LukiBa/RS485-IO-Extension/IO_Overview.xlsx

Raum | HWR | WC unten | Vorhaus | Küche | Speis | Wohnzimmer | Büro | Stiege | Gang oben | KZ Ost | KZ Mitte | KZ Wesst | Schlafzimmer | Schrankraum | Bad | WC Oben | Aussen | Summe | A1 | Q1 | Licht Zugang 1, Licht Zugang 2
Licht 24V | 0 | 1 | 2 | 7 | 0 | 3 | 0 | 1 | 2 | 1 | 1 | 1 | 5 | 2 | 4 | 1 |  | 31 |  | Q2 | Licht Terasse 1, Licht Terasse 2
Licht 230V | 2 | 0 | 0 | 0 | 1 | 0 | 1 | 0 | 0 | 0 | 0 | 0 | 0 | 0 | 0 | 0 |  | 4 |  | Q3 | Licht Terasse 3, Licht Terasse 4
Jalousine | 1 | 0 | 0 | 4 | 0 | 2 | 1 | 0 | 0 | 2 | 1 | 1 | 2 | 1 | 1 | 0 |  | 16 |  | Q4 | Sensorlicht 1,2,3
 |  |  |  |  |  |  |  |  |  |  |  |  |  |  |  |  |  |  |  | Q5 | Licht Küchenzeile
 |  |  |  |  |  |  |  |  |  |  |  |  |  |  |  |  |  |  |  | Q6 | Licht Speis
Relais | 36 |  |  |  |  |  |  |  |  |  |  |  |  |  |  |  |  |  |  | Q7 | Licht HWR1
24V PWMs | 31 |  |  |  |  |  |  |  |  |  |  |  |  |  |  |  |  |  |  | Q8 | Licht HWR2
 |  |  |  |  |  |  |  |  |  |  |  |  |  |  |  |  |  |  | A2 | D1 | Licht 24VDC Spots Essküche Mitte (Spot Kamin) | 1.25 | 0.16
Summe IOs | 67 |  |  |  |  |  |  |  |  |  |  |  |  |  |  |  |  |  |  | D2 | Licht 24VDC Schattenfuge 1 | 1.5 | 0.1333333333
 | 6 |  |  |  |  |  |  |  |  |  |  |  |  |  |  |  |  |  |  | D3 | Licht 24VDC Schattenfuge 3 | 1.5 | 0.1333333333
 |  |  |  |  |  |  |  |  |  |  |  |  |  |  |  |  |  |  |  | D4 | Licht 24VDC Schattenfuge 4 | 1.5 | 0.1333333333
 |  |  |  |  |  |  |  |  |  |  |  |  |  |  |  |  |  |  |  | D5 | Licht 24VDC Spots Küche | 1.25 | 0.16
 |  |  |  |  |  |  |  |  |  |  |  |  |  |  |  |  |  |  |  | D6 | Licht 24VDC Esszimmer | 0.6 | 0.3333333333
 |  | 36 | 27 | 63 |  |  |  |  |  |  |  |  |  |  |  |  |  |  |  | D7 | Licht 24VDC Kochinsel | 0.6 | 0.3333333333
 |  |  |  | 5 |  |  |  |  |  |  |  |  | 64 |  |  |  |  |  |  | D8 | Licht 24VDC WC OG | 0.2 | 1
 |  |  |  |  |  |  |  |  |  |  |  |  |  |  |  |  |  |  |  | Q1 | Jalousie KZ Ost1
 |  |  |  |  |  |  |  |  |  |  |  |  |  |  |  |  |  |  |  | Q2
 |  |  |  |  |  |  |  |  |  |  |  |  |  |  |  |  |  |  |  | Q3 | Jalousie KZ Ost2
 |  |  |  |  |  |  |  |  |  |  |  |  |  |  |  |  |  |  |  | Q4
 |  |  |  |  |  |  |  |  |  |  |  |  |  |  |  |  |  |  |  | Q5 | Jalousie KZ West
 |  |  |  |  |  |  |  |  |  |  |  |  |  |  |  |  |  |  |  | Q6
 |  |  |  |  |  |  |  |  |  |  |  |  |  |  |  |  |  |  |  | Q7 | Jalousie KZ Mitte
 |  |  |  |  |  |  |  |  |  |  |  |  |  |  |  |  |  |  |  | Q8
Arduino CN7 | 17 |  |  |  |  |  |  |  |  |  |  |  |  |  |  |  |  |  |  | Q9 | Licht 230V WC UG
Arduino CN8 | 2
Arduino CN9 | 21 |  |  |  |  |  |  |  |  |  |  |  |  |  |  |  |  |  | A3 | D1 | Licht 24VDC Spots Dusche | 0.9 | 0.2222222222
CN10 | 26 |  |  |  |  |  |  |  |  |  |  |  |  |  |  |  |  |  |  | D2 | Licht 24VDC Spots Badspiegel | 0.625 | 0.32
 |  |  |  |  |  |  |  |  |  |  |  |  |  |  |  |  |  |  |  | D3 | Licht 24VDC Badewanne | 0.625 | 0.32
 |  |  |  |  |  |  |  |  |  |  |  |  |  |  |  |  |  |  |  | D4 | Licht 24VDC Bad | 0.6 | 0.3333333333
 |  |  |  |  |  |  |  |  |  |  |  |  |  |  |  |  |  |  |  | D5 | Licht 24VDC WZ | 0.6 | 0.3333333333
 | 66 |  |  |  |  |  |  |  |  |  |  |  |  |  |  |  |  |  |  | D6 | LED WZ 1 | 1 | 0.2
 |  |  |  |  |  |  |  |  |  |  |  |  |  |  |  |  |  |  |  | D7 | LED WZ 2 | 1 | 0.2
 |  |  |  |  |  |  |  |  |  |  |  |  |  |  |  |  |  |  |  | D8 | Licht 24VDC KZ West | 0.6 | 0.3333333333
 |  |  |  |  |  |  |  |  |  |  |  |  |  |  |  |  |  |  |  | Q1 | Jalousie SZ 1
 |  |  |  |  |  |  |  |  |  |  |  |  |  |  |  |  |  |  |  | Q2
 |  |  |  |  |  |  |  |  |  |  |  |  |  |  |  |  |  |  |  | Q3 | Jalousie SZ 2
 |  |  |  |  |  |  |  |  |  |  |  |  |  |  |  |  |  |  |  | Q4
 |  |  |  |  |  |  |  |  |  |  |  |  |  |  |  |  |  |  |  | Q5 | Jalousie Bad
 |  |  |  |  |  |  |  |  |  |  |  |  |  |  |  |  |  |  |  | Q6
 |  |  |  |  |  |  |  |  |  |  |  |  |  |  |  |  |  |  |  | Q7 | Jalousie Schrankraum
 |  |  |  |  |  |  |  |  |  |  |  |  |  |  |  |  |  |  |  | Q8
 |  |  |  |  |  |  |  |  |  |  |  |  |  |  |  |  |  |  |  | Q9 | Licht Spiegel Vorhaus
 |  |  |  |  |  |  |  |  |  |  |  |  |  |  |  |  |  |  | A4 | D1 | Licht 24VDC SZ2 | 0.6 | 0.3333333333
 |  |  |  |  |  |  |  |  |  |  |  |  |  |  |  |  |  |  |  | D2 | Licht 24VDC KZ Ost | 0.6 | 0.3333333333
 |  |  |  |  |  |  |  |  |  |  |  |  |  |  |  |  |  |  |  | D3 | Licht 24V SZ Nachttisch 2 | 0.2 | 1
 |  |  |  |  |  |  |  |  |  |  |  |  |  |  |  |  |  |  |  | D4 | Licht 24V SZ | 0.2 | 1
 |  |  |  |  |  |  |  |  |  |  |  |  |  |  |  |  |  |  |  | D5 | Licht 24V SZ Nachttisch 1 | 0.2 | 1
 |  |  |  |  |  |  |  |  |  |  |  |  |  |  |  |  |  |  |  | D6 | Licht 24VDC Schrankraum | 1 | 0.2
 |  |  |  |  |  |  |  |  |  |  |  |  |  |  |  |  |  |  |  | D7 | Licht 24VDC LED alle Schränke | 1 | 0.2
 |  |  |  |  |  |  |  |  |  |  |  |  |  |  |  |  |  |  |  | D8 | Licht 24VDC SZ1 | 0.4 | 0.5
 |  |  |  |  |  |  |  |  |  |  |  |  |  |  |  |  |  |  |  | Q1 | Jalousie WZ Tür
 |  |  |  |  |  |  |  |  |  |  |  |  |  |  |  |  |  |  |  | Q2
 |  |  |  |  |  |  |  |  |  |  |  |  |  |  |  |  |  |  |  | Q3 | JalousieTerasse 1
 |  |  |  |  |  |  |  |  |  |  |  |  |  |  |  |  |  |  |  | Q4
 |  |  |  |  |  |  |  |  |  |  |  |  |  |  |  |  |  |  |  | Q5 | JalousieTerasse 2
 |  |  |  |  |  |  |  |  |  |  |  |  |  |  |  |  |  |  |  | Q6
 |  |  |  |  |  |  |  |  |  |  |  |  |  |  |  |  |  |  |  | Q7 | JalousieTerasse 1
 |  |  |  |  |  |  |  |  |  |  |  |  |  |  |  |  |  |  |  | Q8
 |  |  |  |  |  |  |  |  |  |  |  |  |  |  |  |  |  |  |  | Q9
 |  |  |  |  |  |  |  |  |  |  |  |  |  |  |  |  |  |  | A5 | D1 | Licht 24VDC KZ Mitte | 0.6
 |  |  |  |  |  |  |  |  |  |  |  |  |  |  |  |  |  |  |  | D2 | Licht 48VDC LED Gang OG 1
 |  |  |  |  |  |  |  |  |  |  |  |  |  |  |  |  |  |  |  | D3 | Licht 48VDC LED Gang OG 2
 |  |  |  |  |  |  |  |  |  |  |  |  |  |  |  |  |  |  |  | D4 | Licht 48VDC LED Vorhaus 1
 |  |  |  |  |  |  |  |  |  |  |  |  |  |  |  |  |  |  |  | D5 | Licht 48VDC LED Vorhaus 2
 |  |  |  |  |  |  |  |  |  |  |  |  |  |  |  |  |  |  |  | D6 | Licht 24VDC LED Stiege1
 |  |  |  |  |  |  |  |  |  |  |  |  |  |  |  |  |  |  |  | D7 | Handlauf Stiege 1
 |  |  |  |  |  |  |  |  |  |  |  |  |  |  |  |  |  |  |  | D8 | Handlauf Stiege 2
 |  |  |  |  |  |  |  |  |  |  |  |  |  |  |  |  |  |  |  | Q1 | Jalousie EZ
 |  |  |  |  |  |  |  |  |  |  |  |  |  |  |  |  |  |  |  | Q2
 |  |  |  |  |  |  |  |  |  |  |  |  |  |  |  |  |  |  |  | Q3 | Jalousie WZ Fenster
 |  |  |  |  |  |  |  |  |  |  |  |  |  |  |  |  |  |  |  | Q4
 |  |  |  |  |  |  |  |  |  |  |  |  |  |  |  |  |  |  |  | Q5 | Jalousie HWR
 |  |  |  |  |  |  |  |  |  |  |  |  |  |  |  |  |  |  |  | Q6
 |  |  |  |  |  |  |  |  |  |  |  |  |  |  |  |  |  |  |  | Q7 | Jalousie Büro
 |  |  |  |  |  |  |  |  |  |  |  |  |  |  |  |  |  |  |  | Q8
 |  |  |  |  |  |  |  |  |  |  |  |  |  |  |  |  |  |  |  | Q9
