LukiBa/RS485-IO-Extension/io-gateway/bom1.xlsx

Id | Designator | Footprint | Quantity | Designation | Unit Price | Quantitiy for 10 Pics | Quantitiy ordered | Overall Price | Mouser link
1 | C_DIMA_2,C_DIMA_18,C_DIMA_34,C_DIMB_17,C_DIMB_1,C_DIMA_26,C_DIMA_33,C_DIMA_17,C_DIMB_34,C_DIMB_2,C_DIMB_26,C_DIMA_1,C_DIMA_25,C38,C_DIMB_25,C_DIMB_18,C_DIMB_33 | C_1210_3225Metric | 17 | 10ÂµF 50V | €0.40 | 170 | 17 | €6.78 | GRM32EC72A106ME05K Murata Electronics | Mouser Österreich
2 | D_DIMB_1,D_DIMA_7,D_DIMB_7,D_DIMA_9,D_DIMA_5,D_DIMB_5,D_DIMB_9,D_DIMA_1 | D_SMB | 8 | D_Schottky | €0.14 | 80 | 100 | €14.20 | STPS3L60UF STMicroelectronics | Mouser Österreich
3 | K9,K7,K8,K4,K3,K6,K2,K5,K1 | 20715562 | 9 | 2071556-2 | €1.24 | 90 | 10 | €12.40 | 2071556-2 TE Connectivity | Mouser Österreich
4 | D1 | DIOM5436X244N | 1 | SMBJ28A | €0.15 | 10 | 10 | €1.52 | SMBJ28A Bourns | Mouser Österreich
5 | C44 | CP_Elec_6.3x5.4 | 1 | 47 µF | €0.00 | 10 | 0 | €0.00 | Auf Lager
6 | C_DIMA_7,C_DIMB_23,C_DIMA_39,C_DIMB_31,C_DIMB_39,C_DIMB_7,C_DIMA_23,C_DIMA_31 | C_1206_3216Metric | 8 | 1 µF 50V | €0.04 | 80 | 100 | €4.20 | CL31B105KCHNNNE Samsung Electro-Mechanics | Mouser Österreich
7 | J1,J3,J2 | 1752201 | 3 | 1752201 | €12.94 | 30 | 9 | €116.46 | 1311011 Phoenix Contact | Boxes, Enclosures, Racks | DigiKey
8 | D_K8,D_F1,D_K7,D_K1,D_K9,D_K3,D_K4,D_K2,D_K6,D_K5 | D_SOD-123 | 10 | MMSD914 | €0.04 | 100 | 110 | €4.62 | https://www.mouser.at/ProductDetail/onsemi/MMSD914T1G?qs=P4IOph%252Bbot8PMEQIZWg1LQ%3D%3D
9 | D_DIMA_2,D_DIMA_8,D_DIMB_2,D_DIMB_6,D_DIMB_10,D_DIMB_8,D_DIMA_6,D_DIMA_10 | D_SOD-123 | 8 | D_Zener | €0.03 | 80 | 100 | €4.94 | https://www.mouser.at/ProductDetail/863-MMSZ39T1G | BZT52-B68J Nexperia | Mouser Österreich (https://www.mouser.at/ProductDetail/Nexperia/BZT52-B68J?qs=W0yvOO0ixfHDugOwJJQdtw%3D%3D)
10 | C_DIMA_5,C_DIMA_37,C_DIMA_29,C_DIMB_21,C_DIMB_29,C_DIMB_37,C_DIMB_5,C_DIMA_21 | C_0603_1608Metric | 8 | 22pF | €0.02 | 80 | 100 | €2.40 | 06035C220JAT2A KYOCERA AVX | Mouser Österreich
11 | J5,J7,J4,J13,J10,J12,J11,J9,J8 | TerminalBlock_MaiXu_MX126-5.0-02P_1x02_P5.00mm | 9 | Screw_Terminal_01x02 | €0.55 | 90 | 100 | €54.60 | 1-282836-3 TE Connectivity | Mouser Österreich
0.495 | L_DIMB_5,L_DIMB_4,L_DIMB_1,L_DIMA_1,L_DIMA_4,L_DIMA_3,L_DIMA_5,L_DIMB_3 | L_12x12mm_H8mm | 8 | 47µH 3.8A | €0.49 | 80 | 100 | €49.50 | IFDC5050JZER470M Vishay / Dale | Mouser Österreich
13 | U5 | SOT-23-5 | 1 | SN6501DBVR | €1.33 | 10 | 1 | €1.33 | SN6501DBVR Texas Instruments | Mouser Österreich
14 | F1 | Fuse_0603_1608Metric | 1 | Fuse | €0.29 | 10 | 15 | €4.35 | 0ABB-1000-TM Bel Fuse | Mouser Österreich
15 | C1,C9,C3,C8,C5 | C_0603_1608Metric | 5 | 100nF | €0.00 | 50 | 0 | €0.00 | Auf Lager
16 | R29,R31 | R_0603_1608Metric | 10 | 100k | €0.04 | 100 | 100 | €3.50 | https://www.mouser.at/ProductDetail/Vishay-Draloric/RCA0603100KFKEAHP?qs=rrS6PyfT74exmGMHOWeh9Q%3D%3D
17 | R_DIMB_2,R_DIMA_2,R_DIMB_6,R_DIMA_6,R_DIMA_8,R_DIMB_10,R_DIMB_8,R_DIMA_10 | R_0603_1608Metric | 8 | 47k | €0.01 | 80 | 100 | €0.70 | CRCW060347K0JNEAC Vishay | Mouser Österreich
18 | R_DIMA_1,R_DIMB_5,R_DIMA_7,R_DIMB_7,R_DIMA_9,R_DIMB_1,R_DIMA_5,R_DIMB_9 | R_0603_1608Metric | 8 | 33k | €0.003 | 80 | 100 | €0.30 | CR0603-JW-333ELF Bourns | Mouser Österreich
19 | C_DIMA_6,C_DIMB_6,C_DIMA_36,C_DIMB_30,C_DIMA_22,C_DIMA_30,C_DIMA_20,C_DIMB_28,C39,C_DIMB_38,C_DIMB_22,C_DIMA_28,C_DIMA_38,C_DIMA_3,C_DIMB_36,C_DIMB_3,C40,C_DIMB_20 | C_0603_1608Metric | 18 | 100nF 100V | €0.01 | 180 | 200 | €1.60 | CL10B104KC8NNNC Samsung Electro-Mechanics | Mouser Österreich
20 | C6,C7,C2,C4 | C_0603_1608Metric | 4 | 10µF | €0.03 | 40 | 100 | €2.80 | LMK107BBJ106MALT TAIYO YUDEN | Mouser Österreich
21 | L6 | L_Radial_D7.5mm_P3.50mm_Fastron_07P | 1 | 10µH | €0.69 | 10 | 10 | €6.93 | DR0608-103L Coilcraft | Mouser Österreich
22 | TR1 | Transformer_Wuerth_750315371 | 1 | Wuerth_750315371 | €2.11 | 10 | 1 | €2.11 | 750315371 Wurth Elektronik | Mouser Österreich
23 | R2,R1 | R_0603_1608Metric | 2 | 4k7 | €0.01 | 20 | 100 | €0.50 | CR0603-JW-472ELF Bourns | Mouser Österreich
24 | R27 | R_0603_1608Metric | 1 | 470k | €0.01 | 10 | 100 | €0.80 | https://www.mouser.at/ProductDetail/YAGEO/RC0603FR-07470KP?qs=qpJ%252B%252B%252Bdg6p1kr0jBLk7M1w%3D%3D
25 | C_DIMA_4,C_DIMB_27,C_DIMA_27,C_DIMB_19,C_DIMA_35,C_DIMB_4,C_DIMB_35,C_DIMA_19 | C_0603_1608Metric | 8 | 470pF | €0.03 | 80 | 100 | €2.70 | https://www.mouser.at/ProductDetail/Murata-Electronics/GCM1885G2A471JA16D?qs=fGlRhPlbk9z%252BfQIA9svLZw%3D%3D
26 | R_K8,R_F1,R_K6,R_K4,R_K3,R_K2,R_K9,R_K1,R_K7,R_K5 | R_0603_1608Metric | 10 | 100 | €0.01 | 100 | 120 | €0.72 | AC0603JR-07100RL YAGEO | Mouser Österreich
27 | M1 | FanPinHeader_1x03_P2.54mm_Vertical | 1 | Fan_3pin | €0.16 | 10 | 10 | €1.63 | 22-23-2031 Molex | Mouser Österreich
28 | FRDM_MCXA153_1 | FRDM-MCXA153-SMD | 1 | MCU** | €12.75 | 10 | 2 | €25.50 | FRDM-MCXA153 NXP Semiconductors | Mouser Österreich
29 | Q_K8,Q_K2,Q_F1,Q_K7,Q_K4,Q_K3,Q_K1,Q_K5,Q_K6,Q_K9 | SOT-23-3 | 10 | NTR4003NT1G | €0.04 | 100 | 100 | €3.70 | NTR4003NT1G onsemi | Mouser Österreich (https://www.mouser.at/ProductDetail/onsemi/NTR4003NT1G?qs=CBDP9nzV7kme%2Fyh64xROOQ%3D%3D)
30 | U_DIMA4,U_DIMB1,U_DIMB4,U_DIMB5,U_DIMA3,U_DIMA5,U_DIMA1,U_DIMB3 | HSOP-8-1EP_3.9x4.9mm_P1.27mm_EP2.41x3.1mm | 8 | LED5000 | €1.39 | 80 | 10 | €13.90 | LED5000PHR STMicroelectronics | Mouser Österreich (https://www.mouser.at/ProductDetail/STMicroelectronics/LED5000PHR?qs=MSnG1hQWQLXEtGGcTXnZpA%3D%3D)
31 | U6 | SOT-23 | 1 | MCP9700x-ETT | €0.34 | 10 | 2 | €0.69 | MCP9700T-E/LT Microchip Technology | Mouser Österreich (https://www.mouser.at/ProductDetail/Microchip-Technology/MCP9700T-E-LT?qs=RnzODY3cU8tW7jSxAPzBuw%3D%3D)
32 | C41,C42 | C_0603_1608Metric | 2 | 22ÂµF | €0.00 | 20 | 0 | €0.00 | Auf Lager
33 | U3 | SOT-23-6 | 1 | TPS54308 | €0.74 | 10 | 10 | €7.45 | TPS54308DDCR Texas Instruments | Mouser Österreich
34 | RS_DIMB_5,RS_DIMB_1,RS_DIMB_4,RS_DIMA_4,RS_DIMB_3,RS_DIMA_5,RS_DIMA_1,RS_DIMA_3 | R_1206_3216Metric | 8 | 1 || 0,5 || 0,25 | €0.47 | 80 | 50 | €23.50 | AC1206FR-7W1RL YAGEO | Mouser Österreich | RCWE1206R500FKEA Vishay / Dale | Mouser Österreich | RCWE1206R250FKEA Vishay / Dale | Mouser Österreich
35 | C_DIMB_8,C_DIMA_40,C_DIMA_32,C_DIMB_40,C_DIMA_8,C_DIMB_32,C_DIMA_24,C_DIMB_24 | C_1206_3216Metric | 8 | NM | €0.00 | 80 | 0 | €0.00 | Not mounted
36 | U4 | SOIC-16W_7.5x10.3mm_P1.27mm | 1 | ISO7741 | €2.42 | 10 | 10 | €24.20 | ISO7742FTBDWRQ1 Texas Instruments | Mouser Österreich (https://www.mouser.at/ProductDetail/Texas-Instruments/ISO7742FTBDWRQ1?qs=efUn273yAhcm4v0l5sVOsQ%3D%3D)
37 | R4,R3 | R_0603_1608Metric | 2 | R | €0.00 | 20 | 0 | €0.00 | Reserve
38 | D2,D3 | D_SOD-123 | 2 | MBR0520 | €0.11 | 20 | 20 | €2.28 | MBR0520-TP Micro Commercial Components (MCC) | Mouser Österreich (https://www.mouser.at/ProductDetail/Micro-Commercial-Components-MCC/MBR0520-TP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)
39 | R33 | R_0603_1608Metric | 1 | 3k3 | €0.00 | 10 | 0 | €0.00 | Auf Lager
40 | R32 | R_0603_1608Metric | 1 | 10k | €0.00 | 10 | 0 | €0.00 | Auf Lager
41 | C10,C11 | C_0603_1608Metric | 2 | C | €0.00 | 20 | 0 | €0.00 | Reserve
42 | U1 | SOIC-8_3.9x4.9mm_P1.27mm | 1 | SN65LBC176QDR | €2.33 | 10 | 1 | €2.33 | SN65LBC176QDRQ1 Texas Instruments | Mouser Österreich (https://www.mouser.at/ProductDetail/Texas-Instruments/SN65LBC176QDRQ1?qs=UnBokwpwLz%2F%2FuNS0W0w55g%3D%3D)
43 | C43 | C_0603_1608Metric | 1 | 75pF | €0.04 | 10 | 0 | €0.00 | Auf Lager
44 | R30 | R_0603_1608Metric | 1 | 49.9 | €0.00 | 10 | 0 | €0.00 | Auf Lager
45 | U2 | SOT-23-5 | 1 | TPS76350 | €0.70 | 10 | 10 | €6.99 | TPS76350DBVT Texas Instruments | Mouser Österreich (https://www.mouser.at/ProductDetail/Texas-Instruments/TPS76350DBVT?qs=8yeEWhuAOtP%2FFGo0oRuSfA%3D%3D)
46 | MCU J2 | PinHeader 2x20 P2.54 SMD Vertical | 1 |  | €2.98 | 10 | 2 | €5.96 | https://www.mouser.at/ProductDetail/200-HW1011FD610SM
47 | MCU J1 + J3 | PinHeader 2x16 P2.54 SMD Vertical | 2 |  | €2.98 | 20 | 2 | €5.96 | https://www.mouser.at/ProductDetail/200-HW1011FD610SM
48 | MCU J4 | PinHeader 2x12 P2.54 SMD Vertical | 1 |  | €2.98 | 10 | 1 | €2.98 | https://www.mouser.at/ProductDetail/200-HW1011FD610SM
 |  |  |  |  |  |  |  | €424.05
 |  |  |  |  |  |  |  | €307.59
