LukiBa/RS485-IO-Extension/io-gateway/io-gateway.kicad_pcb

## KiCad design io-gateway/io-gateway.kicad_pcb (2025-10-15)

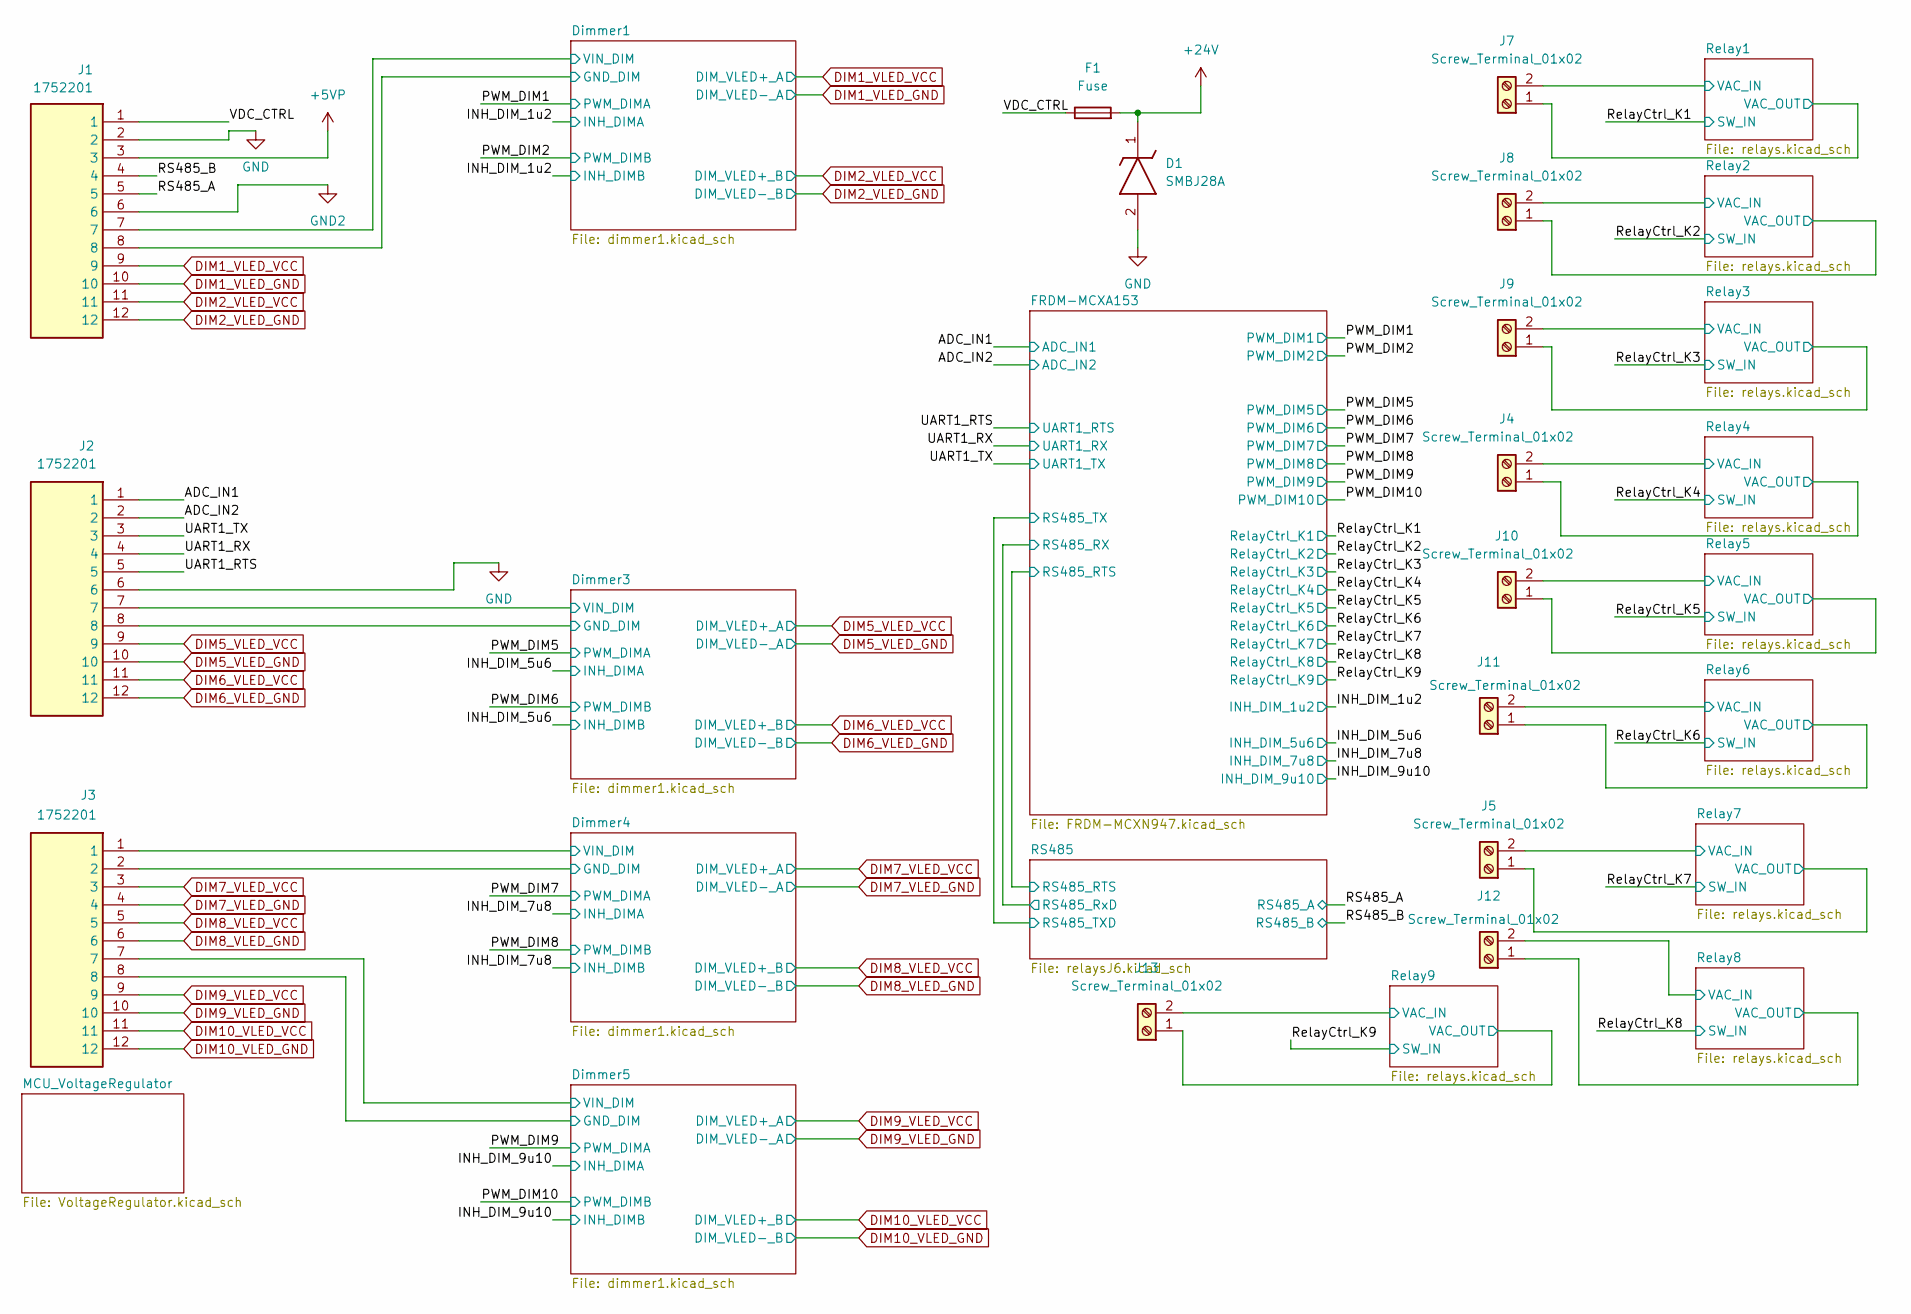
[picture p1: schematic io-gateway.kicad_sch]

Parts:
D1: SMBJ28A; DIOM5436X244N; Mouser Part Number 652-SMBJ28A
F1: Fuse; Fuse_0603_1608Metric
J1, J2, J3: 1752201; Mouser Part Number 651-1752201
J4, J5, J7, J8, J9, J10, J11, J12, J13: Screw_Terminal_01x02; TerminalBlock_MaiXu_MX126-5.0-02P_1x02_P5.00mm

Connections:
+5VP: J1.3; also elsewhere on the board
+24V: D1.1 (K), F1.2; also elsewhere on the board
/ADC_IN1: J2.1; also elsewhere on the board
/ADC_IN2: J2.2; also elsewhere on the board
/Dimmer1/VIN_DIM: J1.7; also elsewhere on the board
/Dimmer3/VIN_DIM: J2.7; also elsewhere on the board
/Dimmer4/VIN_DIM: J3.1; also elsewhere on the board
/Dimmer5/VIN_DIM: J3.7; also elsewhere on the board
/RS485_A: J1.5; also elsewhere on the board
/RS485_B: J1.4; also elsewhere on the board
/Relay1/VAC_IN: J7.2; also elsewhere on the board
/Relay1/VAC_OUT: J7.1; also elsewhere on the board
/Relay2/VAC_IN: J8.2; also elsewhere on the board
/Relay2/VAC_OUT: J8.1; also elsewhere on the board
/Relay3/VAC_IN: J9.2; also elsewhere on the board
/Relay3/VAC_OUT: J9.1; also elsewhere on the board
/Relay4/VAC_IN: J4.2; also elsewhere on the board
/Relay4/VAC_OUT: J4.1; also elsewhere on the board
/Relay5/VAC_IN: J10.2; also elsewhere on the board
/Relay5/VAC_OUT: J10.1; also elsewhere on the board
/Relay6/VAC_IN: J11.2; also elsewhere on the board
/Relay6/VAC_OUT: J11.1; also elsewhere on the board
/Relay7/VAC_IN: J5.2; also elsewhere on the board
/Relay7/VAC_OUT: J5.1; also elsewhere on the board
/Relay8/VAC_IN: J12.2; also elsewhere on the board
/Relay8/VAC_OUT: J12.1; also elsewhere on the board
/Relay9/VAC_IN: J13.2; also elsewhere on the board
/Relay9/VAC_OUT: J13.1; also elsewhere on the board
/UART1_RTS: J2.5; also elsewhere on the board
/UART1_RX: J2.4; also elsewhere on the board
/UART1_TX: J2.3; also elsewhere on the board
/VDC_CTRL: F1.1, J1.1
DIM1_VLED_GND: J1.10; also elsewhere on the board
DIM1_VLED_VCC: J1.9; also elsewhere on the board
DIM2_VLED_GND: J1.12; also elsewhere on the board
DIM2_VLED_VCC: J1.11; also elsewhere on the board
DIM5_VLED_GND: J2.10; also elsewhere on the board
DIM5_VLED_VCC: J2.9; also elsewhere on the board
DIM6_VLED_GND: J2.12; also elsewhere on the board
DIM6_VLED_VCC: J2.11; also elsewhere on the board
DIM7_VLED_GND: J3.4; also elsewhere on the board
DIM7_VLED_VCC: J3.3; also elsewhere on the board
DIM8_VLED_GND: J3.6; also elsewhere on the board
DIM8_VLED_VCC: J3.5; also elsewhere on the board
DIM9_VLED_GND: J3.10; also elsewhere on the board
DIM9_VLED_VCC: J3.9; also elsewhere on the board
DIM10_VLED_GND: J3.12; also elsewhere on the board
DIM10_VLED_VCC: J3.11; also elsewhere on the board
GND: D1.2 (A), J1.2, J1.8, J2.6, J2.8, J3.2, J3.8; also elsewhere on the board
GND2: J1.6; also elsewhere on the board

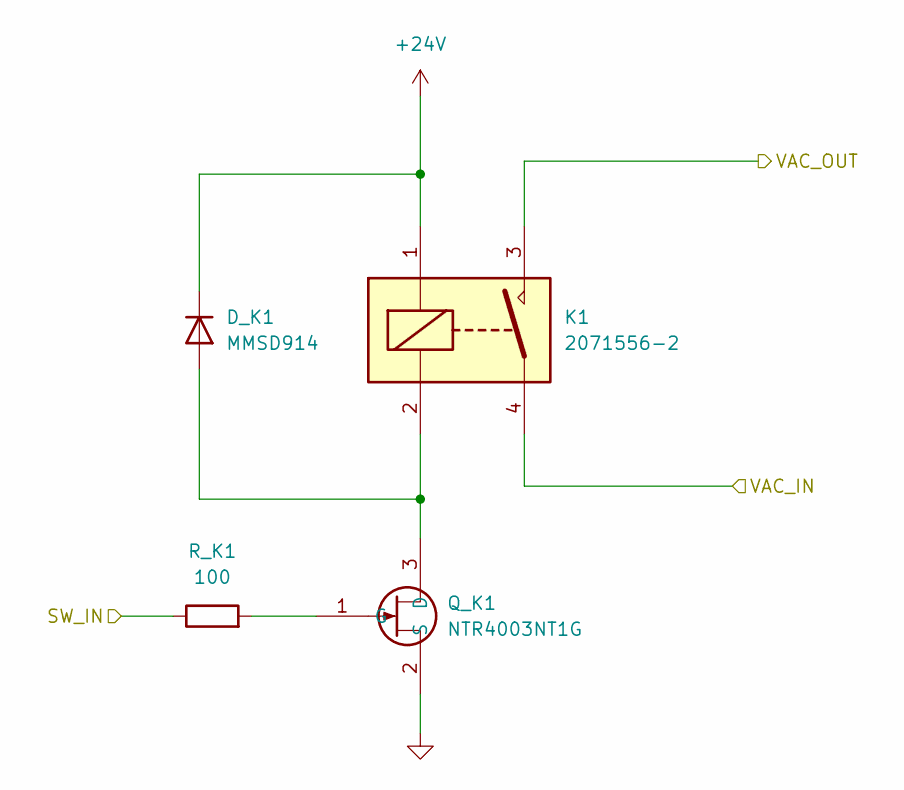
[picture p2: schematic relays.kicad_sch]

Parts:
D_K1: MMSD914; D_SOD-123
K1: 2071556-2; 20715562; Mouser Part Number 655-2071556-2
Q_K1: NTR4003NT1G; SOT-23-3; Mouser Part Number 863-NTR4003NT1G
R_K1: 100; R_0603_1608Metric

Connections:
+24V: D_K1.1 (K), K1.1 (COIL_1); also elsewhere on the board
/Relay1/VAC_IN: K1.4 (NO); also elsewhere on the board
/Relay1/VAC_OUT: K1.3 (COM); also elsewhere on the board
/RelayCtrl_K1: R_K1.1; also elsewhere on the board
GND: Q_K1.2 (S); also elsewhere on the board
unnamed: D_K1.2 (A), K1.2 (COIL_2), Q_K1.3 (D)
unnamed: Q_K1.1 (G), R_K1.2

Parts of its further copies:
D_K2, D_K3, D_K4, D_K5, D_K6, D_K7, D_K8, D_K9: MMSD914; D_SOD-123
K2, K3, K4, K5, K6, K7, K8, K9: 2071556-2; 20715562; Mouser Part Number 655-2071556-2
Q_K2, Q_K3, Q_K4, Q_K5, Q_K6, Q_K7, Q_K8, Q_K9: NTR4003NT1G; SOT-23-3; Mouser Part Number 863-NTR4003NT1G
R_K2, R_K3, R_K4, R_K5, R_K6, R_K7, R_K8, R_K9: 100; R_0603_1608Metric

Connections of its further copies:
+24V: D_K2.1 (K), D_K3.1 (K), D_K4.1 (K), D_K5.1 (K), D_K6.1 (K), D_K7.1 (K), D_K8.1 (K), D_K9.1 (K), K2.1 (COIL_1), K3.1 (COIL_1), K4.1 (COIL_1), K5.1 (COIL_1), K6.1 (COIL_1), K7.1 (COIL_1), K8.1 (COIL_1), K9.1 (COIL_1); also elsewhere on the board
/Relay2/VAC_IN: K2.4 (NO); also elsewhere on the board
/Relay2/VAC_OUT: K2.3 (COM); also elsewhere on the board
/Relay3/VAC_IN: K3.4 (NO); also elsewhere on the board
/Relay3/VAC_OUT: K3.3 (COM); also elsewhere on the board
/Relay4/VAC_IN: K4.4 (NO); also elsewhere on the board
/Relay4/VAC_OUT: K4.3 (COM); also elsewhere on the board
/Relay5/VAC_IN: K5.4 (NO); also elsewhere on the board
/Relay5/VAC_OUT: K5.3 (COM); also elsewhere on the board
/Relay6/VAC_IN: K6.4 (NO); also elsewhere on the board
/Relay6/VAC_OUT: K6.3 (COM); also elsewhere on the board
/Relay7/VAC_IN: K7.4 (NO); also elsewhere on the board
/Relay7/VAC_OUT: K7.3 (COM); also elsewhere on the board
/Relay8/VAC_IN: K8.4 (NO); also elsewhere on the board
/Relay8/VAC_OUT: K8.3 (COM); also elsewhere on the board
/Relay9/VAC_IN: K9.4 (NO); also elsewhere on the board
/Relay9/VAC_OUT: K9.3 (COM); also elsewhere on the board
/RelayCtrl_K2: R_K2.1; also elsewhere on the board
/RelayCtrl_K3: R_K3.1; also elsewhere on the board
/RelayCtrl_K4: R_K4.1; also elsewhere on the board
/RelayCtrl_K5: R_K5.1; also elsewhere on the board
/RelayCtrl_K6: R_K6.1; also elsewhere on the board
/RelayCtrl_K7: R_K7.1; also elsewhere on the board
/RelayCtrl_K8: R_K8.1; also elsewhere on the board
/RelayCtrl_K9: R_K9.1; also elsewhere on the board
GND: Q_K2.2 (S), Q_K3.2 (S), Q_K4.2 (S), Q_K5.2 (S), Q_K6.2 (S), Q_K7.2 (S), Q_K8.2 (S), Q_K9.2 (S); also elsewhere on the board
unnamed: D_K2.2 (A), K2.2 (COIL_2), Q_K2.3 (D)
unnamed: D_K3.2 (A), K3.2 (COIL_2), Q_K3.3 (D)
unnamed: D_K4.2 (A), K4.2 (COIL_2), Q_K4.3 (D)
unnamed: D_K5.2 (A), K5.2 (COIL_2), Q_K5.3 (D)
unnamed: D_K6.2 (A), K6.2 (COIL_2), Q_K6.3 (D)
unnamed: D_K7.2 (A), K7.2 (COIL_2), Q_K7.3 (D)
unnamed: D_K8.2 (A), K8.2 (COIL_2), Q_K8.3 (D)
unnamed: D_K9.2 (A), K9.2 (COIL_2), Q_K9.3 (D)
unnamed: Q_K2.1 (G), R_K2.2
unnamed: Q_K3.1 (G), R_K3.2
unnamed: Q_K4.1 (G), R_K4.2
unnamed: Q_K5.1 (G), R_K5.2
unnamed: Q_K6.1 (G), R_K6.2
unnamed: Q_K7.1 (G), R_K7.2
unnamed: Q_K8.1 (G), R_K8.2
unnamed: Q_K9.1 (G), R_K9.2

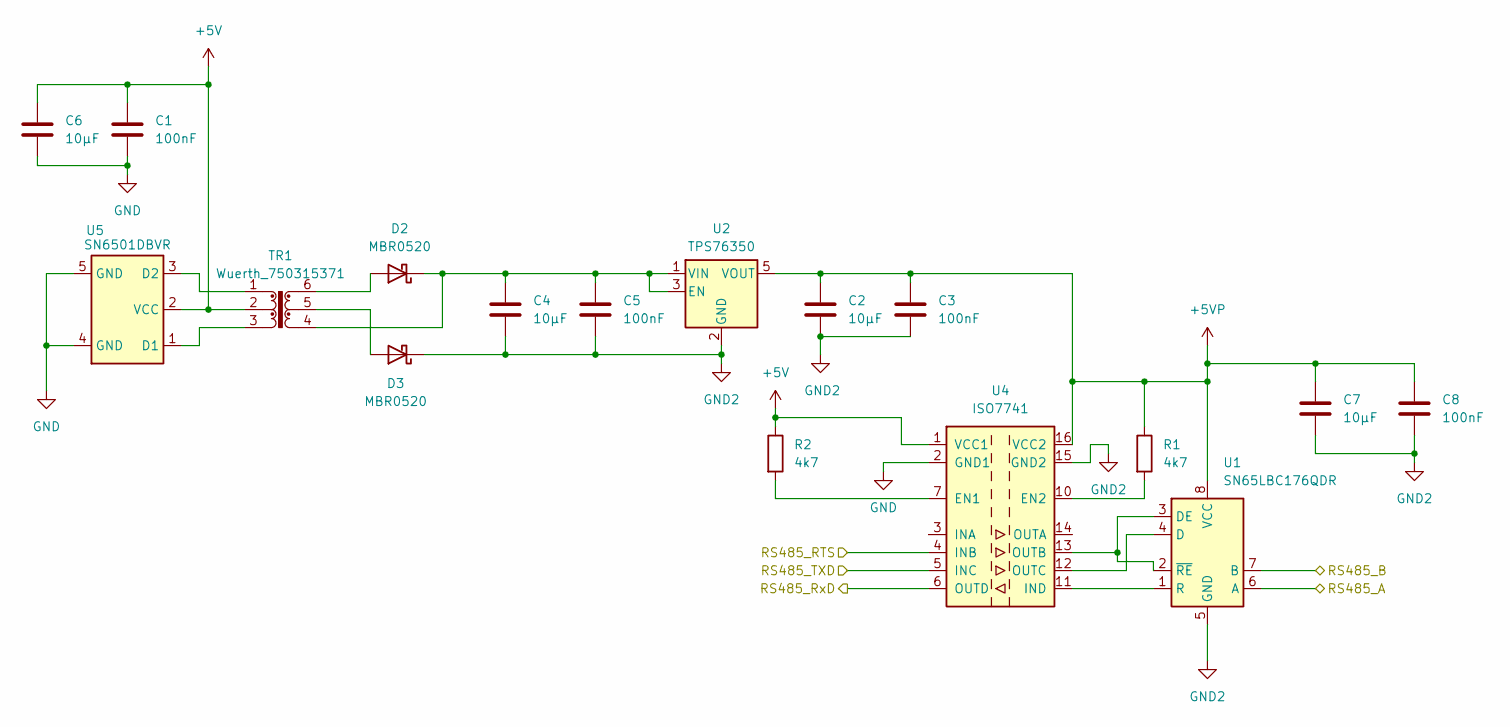
[picture p3: schematic relaysJ6.kicad_sch]

Parts:
C1, C3, C5, C8: 100nF; C_0603_1608Metric
C2, C4, C6, C7: 10µF; C_0603_1608Metric
D2, D3: MBR0520; D_SOD-123
R1, R2: 4k7; R_0603_1608Metric
TR1: Wuerth_750315371; Transformer_Wuerth_750315371
U1: SN65LBC176QDR; SOIC-8_3.9x4.9mm_P1.27mm
U2: TPS76350; SOT-23-5
U4: ISO7741; SOIC-16W_7.5x10.3mm_P1.27mm
U5: SN6501DBVR; SOT-23-5

Connections:
+5V: C1.1, C6.1, R2.1, TR1.2, U4.1 (VCC1), U5.2 (VCC); also elsewhere on the board
+5VP: C2.1, C3.1, C7.1, C8.1, R1.1, U1.8 (VCC), U2.5 (VOUT), U4.16 (VCC2); also elsewhere on the board
/FRDM-MCXA153/RS485_RTS: U4.4 (INB); also elsewhere on the board
/FRDM-MCXA153/RS485_RX: U4.6 (OUTD); also elsewhere on the board
/FRDM-MCXA153/RS485_TX: U4.5 (INC); also elsewhere on the board
/RS485_A: U1.6 (A); also elsewhere on the board
/RS485_B: U1.7 (B); also elsewhere on the board
GND: C1.2, C6.2, U4.2 (GND1), U4.8 (GND1), U5.4 (GND), U5.5 (GND); also elsewhere on the board
GND2: C2.2, C3.2, C4.2, C5.2, C7.2, C8.2, D3.1 (K), U1.5 (GND), U2.2 (GND), U4.9 (GND2), U4.15 (GND2); also elsewhere on the board
unnamed: D2.2 (A), TR1.6
unnamed: C4.1, C5.1, D2.1 (K), TR1.4, U2.1 (VIN), U2.3 (EN)
unnamed: D3.2 (A), TR1.5
unnamed: U1.4 (D), U4.12 (OUTC)
unnamed: U1.2 (~RE), U1.3 (DE), U4.13 (OUTB)
unnamed: U1.1 (R), U4.11 (IND)
unnamed: R2.2, U4.7 (EN1)
unnamed: R1.2, U4.10 (EN2)
unnamed: TR1.3, U5.1 (D1)
unnamed: TR1.1, U5.3 (D2)

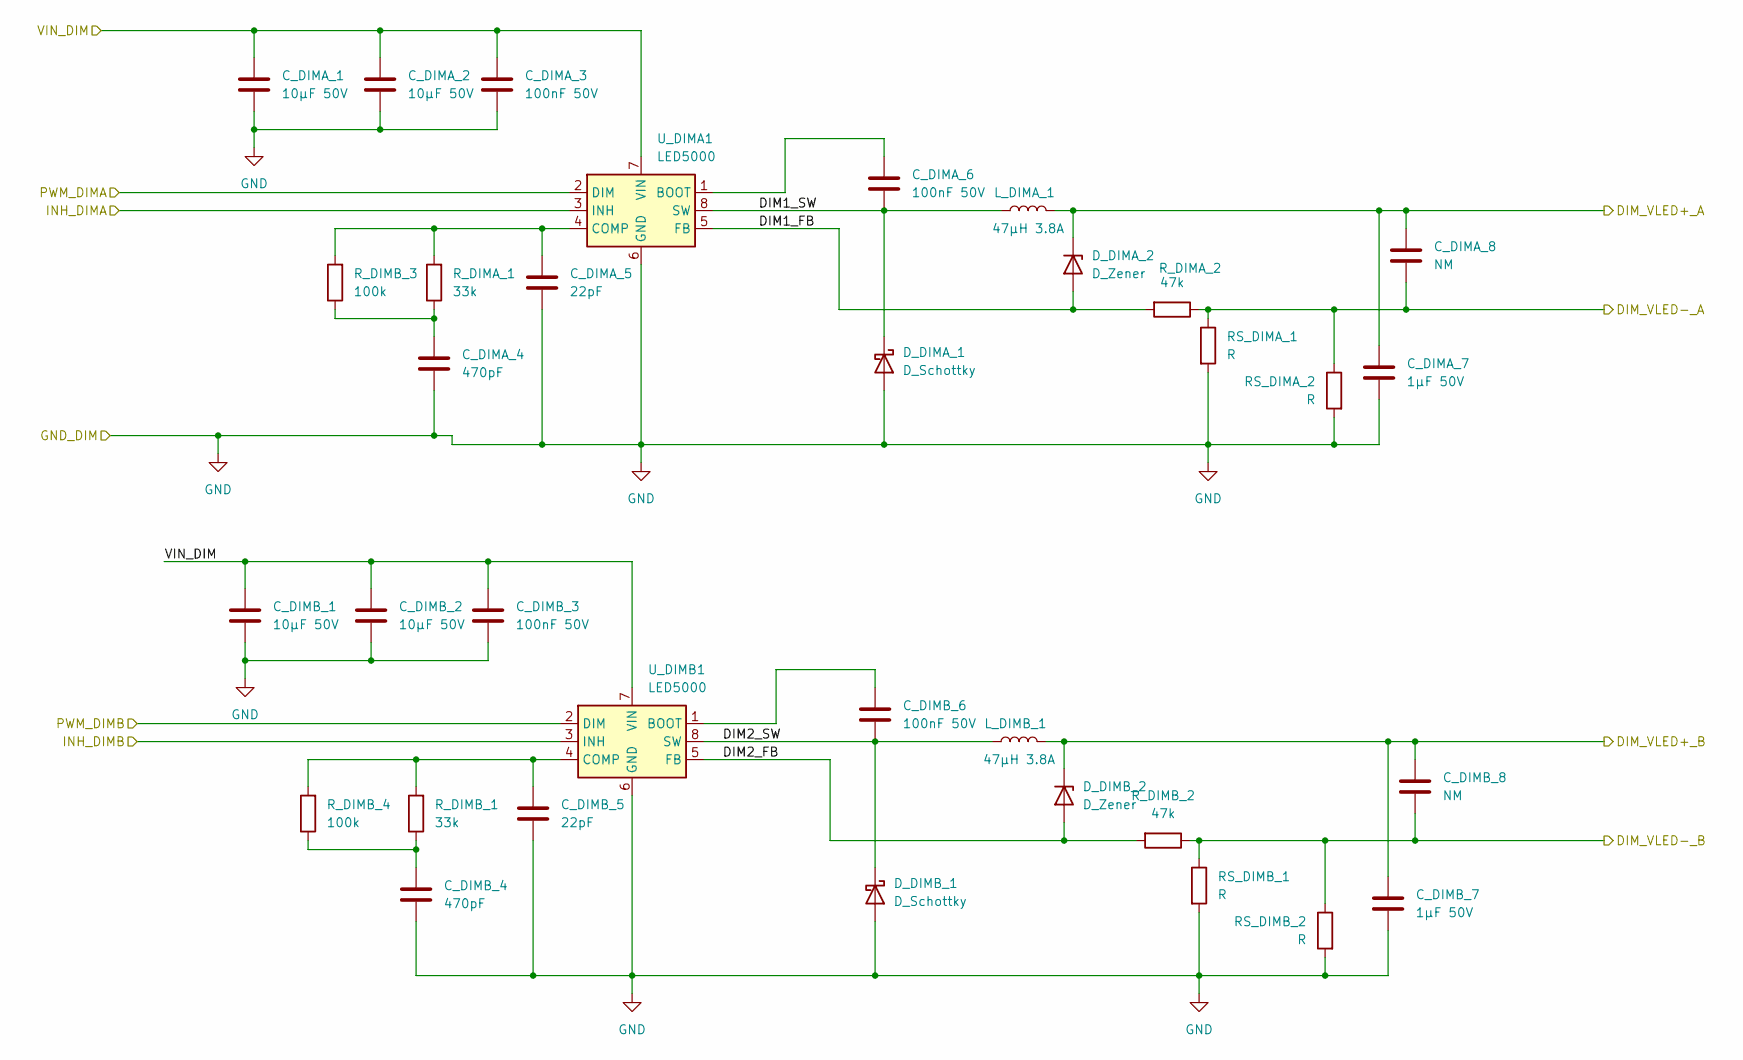
[picture p4: schematic dimmer1.kicad_sch]

Parts:
C_DIMA_1, C_DIMA_2: 10µF 50V; C_1210_3225Metric
C_DIMA_3, C_DIMA_6: 100nF 50V; C_0603_1608Metric
C_DIMA_4: 470pF; C_0603_1608Metric
C_DIMA_5: 22pF; C_0603_1608Metric
C_DIMA_7: 1µF 50V; C_1206_3216Metric
C_DIMA_8: NM; C_1206_3216Metric
C_DIMB_1, C_DIMB_2: 10µF 50V; C_1210_3225Metric
C_DIMB_3, C_DIMB_6: 100nF 50V; C_0603_1608Metric
C_DIMB_4: 470pF; C_0603_1608Metric
C_DIMB_5: 22pF; C_0603_1608Metric
C_DIMB_7: 1µF 50V; C_1206_3216Metric
C_DIMB_8: NM; C_1206_3216Metric
D_DIMA_1: D_Schottky; D_SMB
D_DIMA_2: D_Zener; D_SOD-123
D_DIMB_1: D_Schottky; D_SMB
D_DIMB_2: D_Zener; D_SOD-123
L_DIMA_1: 47µH 3.8A; L_12x12mm_H8mm
L_DIMB_1: 47µH 3.8A; L_12x12mm_H8mm
RS_DIMA_1, RS_DIMA_2: R; R_1206_3216Metric
RS_DIMB_1, RS_DIMB_2: R; R_1206_3216Metric
R_DIMA_1: 33k; R_0603_1608Metric
R_DIMA_2: 47k; R_0603_1608Metric
R_DIMB_1: 33k; R_0603_1608Metric
R_DIMB_2: 47k; R_0603_1608Metric
R_DIMB_3, R_DIMB_4: 100k; R_0603_1608Metric
U_DIMA1: LED5000; HSOP-8-1EP_3.9x4.9mm_P1.27mm_EP2.41x3.1mm
U_DIMB1: LED5000; HSOP-8-1EP_3.9x4.9mm_P1.27mm_EP2.41x3.1mm

Connections:
/Dimmer1/DIM1_FB: D_DIMA_2.2 (A), R_DIMA_2.2, U_DIMA1.5 (FB)
/Dimmer1/DIM1_SW: C_DIMA_6.2, D_DIMA_1.1 (K), L_DIMA_1.2, U_DIMA1.8 (SW)
/Dimmer1/DIM2_FB: D_DIMB_2.2 (A), R_DIMB_2.2, U_DIMB1.5 (FB)
/Dimmer1/DIM2_SW: C_DIMB_6.2, D_DIMB_1.1 (K), L_DIMB_1.2, U_DIMB1.8 (SW)
/Dimmer1/VIN_DIM: C_DIMA_1.1, C_DIMA_2.1, C_DIMA_3.1, C_DIMB_1.1, C_DIMB_2.1, C_DIMB_3.1, U_DIMA1.7 (VIN), U_DIMB1.7 (VIN); also elsewhere on the board
/INH_DIM_1u2: U_DIMA1.3 (INH), U_DIMB1.3 (INH); also elsewhere on the board
/PWM_DIM1: U_DIMA1.2 (DIM); also elsewhere on the board
/PWM_DIM2: U_DIMB1.2 (DIM); also elsewhere on the board
DIM1_VLED_GND: C_DIMA_8.2, RS_DIMA_1.1, RS_DIMA_2.1, R_DIMA_2.1; also elsewhere on the board
DIM1_VLED_VCC: C_DIMA_7.1, C_DIMA_8.1, D_DIMA_2.1 (K), L_DIMA_1.1; also elsewhere on the board
DIM2_VLED_GND: C_DIMB_8.2, RS_DIMB_1.1, RS_DIMB_2.1, R_DIMB_2.1; also elsewhere on the board
DIM2_VLED_VCC: C_DIMB_7.1, C_DIMB_8.1, D_DIMB_2.1 (K), L_DIMB_1.1; also elsewhere on the board
GND: C_DIMA_1.2, C_DIMA_2.2, C_DIMA_3.2, C_DIMA_4.2, C_DIMA_5.2, C_DIMA_7.2, C_DIMB_1.2, C_DIMB_2.2, C_DIMB_3.2, C_DIMB_4.2, C_DIMB_5.2, C_DIMB_7.2, D_DIMA_1.2 (A), D_DIMB_1.2 (A), RS_DIMA_1.2, RS_DIMA_2.2, RS_DIMB_1.2, RS_DIMB_2.2, U_DIMA1.6 (GND), U_DIMA1.9 (GND), U_DIMB1.6 (GND), U_DIMB1.9 (GND); also elsewhere on the board
unnamed: C_DIMA_4.1, R_DIMA_1.1, R_DIMB_3.1
unnamed: C_DIMB_4.1, R_DIMB_1.1, R_DIMB_4.1
unnamed: C_DIMA_6.1, U_DIMA1.1 (BOOT)
unnamed: C_DIMA_5.1, R_DIMA_1.2, R_DIMB_3.2, U_DIMA1.4 (COMP)
unnamed: C_DIMB_6.1, U_DIMB1.1 (BOOT)
unnamed: C_DIMB_5.1, R_DIMB_1.2, R_DIMB_4.2, U_DIMB1.4 (COMP)

Parts of its further copies:
C_DIMA_17, C_DIMA_18, C_DIMA_25, C_DIMA_26, C_DIMA_33, C_DIMA_34: 10µF 50V; C_1210_3225Metric
C_DIMA_19, C_DIMA_27, C_DIMA_35: 470pF; C_0603_1608Metric
C_DIMA_20, C_DIMA_22, C_DIMA_28, C_DIMA_30, C_DIMA_36, C_DIMA_38: 100nF 50V; C_0603_1608Metric
C_DIMA_21, C_DIMA_29, C_DIMA_37: 22pF; C_0603_1608Metric
C_DIMA_23, C_DIMA_31, C_DIMA_39: 1µF 50V; C_1206_3216Metric
C_DIMA_24, C_DIMA_32, C_DIMA_40: NM; C_1206_3216Metric
C_DIMB_17, C_DIMB_18, C_DIMB_25, C_DIMB_26, C_DIMB_33, C_DIMB_34: 10µF 50V; C_1210_3225Metric
C_DIMB_19, C_DIMB_27, C_DIMB_35: 470pF; C_0603_1608Metric
C_DIMB_20, C_DIMB_22, C_DIMB_28, C_DIMB_30, C_DIMB_36, C_DIMB_38: 100nF 50V; C_0603_1608Metric
C_DIMB_21, C_DIMB_29, C_DIMB_37: 22pF; C_0603_1608Metric
C_DIMB_23, C_DIMB_31, C_DIMB_39: 1µF 50V; C_1206_3216Metric
C_DIMB_24, C_DIMB_32, C_DIMB_40: NM; C_1206_3216Metric
D_DIMA_5, D_DIMA_7, D_DIMA_9: D_Schottky; D_SMB
D_DIMA_6, D_DIMA_8, D_DIMA_10: D_Zener; D_SOD-123
D_DIMB_5, D_DIMB_7, D_DIMB_9: D_Schottky; D_SMB
D_DIMB_6, D_DIMB_8, D_DIMB_10: D_Zener; D_SOD-123
L_DIMA_3, L_DIMA_4, L_DIMA_5: 47µH 3.8A; L_12x12mm_H8mm
L_DIMB_3, L_DIMB_4, L_DIMB_5: 47µH 3.8A; L_12x12mm_H8mm
RS_DIMA_3, RS_DIMA_4, RS_DIMA_5, RS_DIMA_6, RS_DIMA_7, RS_DIMA_8: R; R_1206_3216Metric
RS_DIMB_3, RS_DIMB_4, RS_DIMB_5, RS_DIMB_6, RS_DIMB_7, RS_DIMB_8: R; R_1206_3216Metric
R_DIMA_5, R_DIMA_7, R_DIMA_9: 33k; R_0603_1608Metric
R_DIMA_6, R_DIMA_8, R_DIMA_10: 47k; R_0603_1608Metric
R_DIMB_5, R_DIMB_7, R_DIMB_9: 33k; R_0603_1608Metric
R_DIMB_6, R_DIMB_8, R_DIMB_10: 47k; R_0603_1608Metric
R_DIMB_11, R_DIMB_12, R_DIMB_13, R_DIMB_32, R_DIMB_33, R_DIMB_34: 100k; R_0603_1608Metric
U_DIMA3, U_DIMA4, U_DIMA5: LED5000; HSOP-8-1EP_3.9x4.9mm_P1.27mm_EP2.41x3.1mm
U_DIMB3, U_DIMB4, U_DIMB5: LED5000; HSOP-8-1EP_3.9x4.9mm_P1.27mm_EP2.41x3.1mm

Connections of its further copies:
/Dimmer3/DIM1_FB: D_DIMA_6.2 (A), R_DIMA_6.2, U_DIMA3.5 (FB)
/Dimmer3/DIM1_SW: C_DIMA_22.2, D_DIMA_5.1 (K), L_DIMA_3.2, U_DIMA3.8 (SW)
/Dimmer3/DIM2_FB: D_DIMB_6.2 (A), R_DIMB_6.2, U_DIMB3.5 (FB)
/Dimmer3/DIM2_SW: C_DIMB_22.2, D_DIMB_5.1 (K), L_DIMB_3.2, U_DIMB3.8 (SW)
/Dimmer3/VIN_DIM: C_DIMA_17.1, C_DIMA_18.1, C_DIMA_20.1, C_DIMB_17.1, C_DIMB_18.1, C_DIMB_20.1, U_DIMA3.7 (VIN), U_DIMB3.7 (VIN); also elsewhere on the board
/Dimmer4/DIM1_FB: D_DIMA_8.2 (A), R_DIMA_8.2, U_DIMA4.5 (FB)
/Dimmer4/DIM1_SW: C_DIMA_30.2, D_DIMA_7.1 (K), L_DIMA_4.2, U_DIMA4.8 (SW)
/Dimmer4/DIM2_FB: D_DIMB_8.2 (A), R_DIMB_8.2, U_DIMB4.5 (FB)
/Dimmer4/DIM2_SW: C_DIMB_30.2, D_DIMB_7.1 (K), L_DIMB_4.2, U_DIMB4.8 (SW)
/Dimmer4/VIN_DIM: C_DIMA_25.1, C_DIMA_26.1, C_DIMA_28.1, C_DIMB_25.1, C_DIMB_26.1, C_DIMB_28.1, U_DIMA4.7 (VIN), U_DIMB4.7 (VIN); also elsewhere on the board
/Dimmer5/DIM1_FB: D_DIMA_10.2 (A), R_DIMA_10.2, U_DIMA5.5 (FB)
/Dimmer5/DIM1_SW: C_DIMA_38.2, D_DIMA_9.1 (K), L_DIMA_5.2, U_DIMA5.8 (SW)
/Dimmer5/DIM2_FB: D_DIMB_10.2 (A), R_DIMB_10.2, U_DIMB5.5 (FB)
/Dimmer5/DIM2_SW: C_DIMB_38.2, D_DIMB_9.1 (K), L_DIMB_5.2, U_DIMB5.8 (SW)
/Dimmer5/VIN_DIM: C_DIMA_33.1, C_DIMA_34.1, C_DIMA_36.1, C_DIMB_33.1, C_DIMB_34.1, C_DIMB_36.1, U_DIMA5.7 (VIN), U_DIMB5.7 (VIN); also elsewhere on the board
/INH_DIM_5u6: U_DIMA3.3 (INH), U_DIMB3.3 (INH); also elsewhere on the board
/INH_DIM_7u8: U_DIMA4.3 (INH), U_DIMB4.3 (INH); also elsewhere on the board
/INH_DIM_9u10: U_DIMA5.3 (INH), U_DIMB5.3 (INH); also elsewhere on the board
/PWM_DIM5: U_DIMA3.2 (DIM); also elsewhere on the board
/PWM_DIM6: U_DIMB3.2 (DIM); also elsewhere on the board
/PWM_DIM7: U_DIMA4.2 (DIM); also elsewhere on the board
/PWM_DIM8: U_DIMB4.2 (DIM); also elsewhere on the board
/PWM_DIM9: U_DIMA5.2 (DIM); also elsewhere on the board
/PWM_DIM10: U_DIMB5.2 (DIM); also elsewhere on the board
DIM5_VLED_GND: C_DIMA_24.2, RS_DIMA_3.1, RS_DIMA_6.1, R_DIMA_6.1; also elsewhere on the board
DIM5_VLED_VCC: C_DIMA_23.1, C_DIMA_24.1, D_DIMA_6.1 (K), L_DIMA_3.1; also elsewhere on the board
DIM6_VLED_GND: C_DIMB_24.2, RS_DIMB_3.1, RS_DIMB_6.1, R_DIMB_6.1; also elsewhere on the board
DIM6_VLED_VCC: C_DIMB_23.1, C_DIMB_24.1, D_DIMB_6.1 (K), L_DIMB_3.1; also elsewhere on the board
DIM7_VLED_GND: C_DIMA_32.2, RS_DIMA_4.1, RS_DIMA_7.1, R_DIMA_8.1; also elsewhere on the board
DIM7_VLED_VCC: C_DIMA_31.1, C_DIMA_32.1, D_DIMA_8.1 (K), L_DIMA_4.1; also elsewhere on the board
DIM8_VLED_GND: C_DIMB_32.2, RS_DIMB_4.1, RS_DIMB_7.1, R_DIMB_8.1; also elsewhere on the board
DIM8_VLED_VCC: C_DIMB_31.1, C_DIMB_32.1, D_DIMB_8.1 (K), L_DIMB_4.1; also elsewhere on the board
DIM9_VLED_GND: C_DIMA_40.2, RS_DIMA_5.1, RS_DIMA_8.1, R_DIMA_10.1; also elsewhere on the board
DIM9_VLED_VCC: C_DIMA_39.1, C_DIMA_40.1, D_DIMA_10.1 (K), L_DIMA_5.1; also elsewhere on the board
DIM10_VLED_GND: C_DIMB_40.2, RS_DIMB_5.1, RS_DIMB_8.1, R_DIMB_10.1; also elsewhere on the board
DIM10_VLED_VCC: C_DIMB_39.1, C_DIMB_40.1, D_DIMB_10.1 (K), L_DIMB_5.1; also elsewhere on the board
GND: C_DIMA_17.2, C_DIMA_18.2, C_DIMA_19.2, C_DIMA_20.2, C_DIMA_21.2, C_DIMA_23.2, C_DIMA_25.2, C_DIMA_26.2, C_DIMA_27.2, C_DIMA_28.2, C_DIMA_29.2, C_DIMA_31.2, C_DIMA_33.2, C_DIMA_34.2, C_DIMA_35.2, C_DIMA_36.2, C_DIMA_37.2, C_DIMA_39.2, C_DIMB_17.2, C_DIMB_18.2, C_DIMB_19.2, C_DIMB_20.2, C_DIMB_21.2, C_DIMB_23.2, C_DIMB_25.2, C_DIMB_26.2, C_DIMB_27.2, C_DIMB_28.2, C_DIMB_29.2, C_DIMB_31.2, C_DIMB_33.2, C_DIMB_34.2, C_DIMB_35.2, C_DIMB_36.2, C_DIMB_37.2, C_DIMB_39.2, D_DIMA_5.2 (A), D_DIMA_7.2 (A), D_DIMA_9.2 (A), D_DIMB_5.2 (A), D_DIMB_7.2 (A), D_DIMB_9.2 (A), RS_DIMA_3.2, RS_DIMA_4.2, RS_DIMA_5.2, RS_DIMA_6.2, RS_DIMA_7.2, RS_DIMA_8.2, RS_DIMB_3.2, RS_DIMB_4.2, RS_DIMB_5.2, RS_DIMB_6.2, RS_DIMB_7.2, RS_DIMB_8.2, U_DIMA3.6 (GND), U_DIMA3.9 (GND), U_DIMA4.6 (GND), U_DIMA4.9 (GND), U_DIMA5.6 (GND), U_DIMA5.9 (GND), U_DIMB3.6 (GND), U_DIMB3.9 (GND), U_DIMB4.6 (GND), U_DIMB4.9 (GND), U_DIMB5.6 (GND), U_DIMB5.9 (GND); also elsewhere on the board
unnamed: C_DIMA_19.1, R_DIMA_5.1, R_DIMB_32.1
unnamed: C_DIMA_27.1, R_DIMA_7.1, R_DIMB_33.1
unnamed: C_DIMA_35.1, R_DIMA_9.1, R_DIMB_34.1
unnamed: C_DIMB_19.1, R_DIMB_5.1, R_DIMB_11.1
unnamed: C_DIMB_27.1, R_DIMB_7.1, R_DIMB_12.1
unnamed: C_DIMB_35.1, R_DIMB_9.1, R_DIMB_13.1
unnamed: C_DIMA_22.1, U_DIMA3.1 (BOOT)
unnamed: C_DIMA_21.1, R_DIMA_5.2, R_DIMB_32.2, U_DIMA3.4 (COMP)
unnamed: C_DIMA_30.1, U_DIMA4.1 (BOOT)
unnamed: C_DIMA_29.1, R_DIMA_7.2, R_DIMB_33.2, U_DIMA4.4 (COMP)
unnamed: C_DIMA_38.1, U_DIMA5.1 (BOOT)
unnamed: C_DIMA_37.1, R_DIMA_9.2, R_DIMB_34.2, U_DIMA5.4 (COMP)
unnamed: C_DIMB_22.1, U_DIMB3.1 (BOOT)
unnamed: C_DIMB_21.1, R_DIMB_5.2, R_DIMB_11.2, U_DIMB3.4 (COMP)
unnamed: C_DIMB_30.1, U_DIMB4.1 (BOOT)
unnamed: C_DIMB_29.1, R_DIMB_7.2, R_DIMB_12.2, U_DIMB4.4 (COMP)
unnamed: C_DIMB_38.1, U_DIMB5.1 (BOOT)
unnamed: C_DIMB_37.1, R_DIMB_9.2, R_DIMB_13.2, U_DIMB5.4 (COMP)

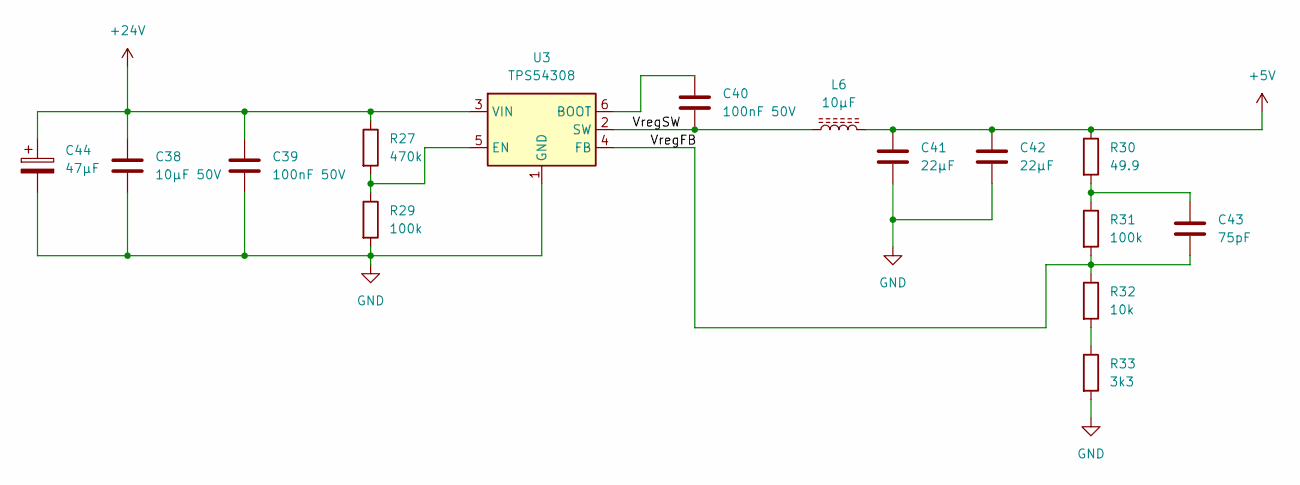
[picture p5: schematic VoltageRegulator.kicad_sch]

Parts:
C38: 10µF 50V; C_1210_3225Metric
C39, C40: 100nF 50V; C_0603_1608Metric
C41, C42: 22µF; C_0603_1608Metric
C43: 75pF; C_0603_1608Metric
C44: 47µF; CP_Elec_6.3x5.4
L6: 10µF; L_Radial_D7.5mm_P3.50mm_Fastron_07P
R27: 470k; R_0603_1608Metric
R29, R31: 100k; R_0603_1608Metric
R30: 49.9; R_0603_1608Metric
R32: 10k; R_0603_1608Metric
R33: 3k3; R_0603_1608Metric
U3: TPS54308; SOT-23-6

Connections:
+5V: C41.1, C42.1, L6.2, R30.1; also elsewhere on the board
+24V: C38.1, C39.1, C44.1, R27.1, U3.3 (VIN); also elsewhere on the board
/MCU_VoltageRegulator/VregFB: C43.2, R31.2, R32.1, U3.4 (FB)
/MCU_VoltageRegulator/VregSW: C40.2, L6.1, U3.2 (SW)
GND: C38.2, C39.2, C41.2, C42.2, C44.2, R29.2, R33.2, U3.1 (GND); also elsewhere on the board
unnamed: C43.1, R30.2, R31.1
unnamed: R32.2, R33.1
unnamed: C40.1, U3.6 (BOOT)
unnamed: R27.2, R29.1, U3.5 (EN)

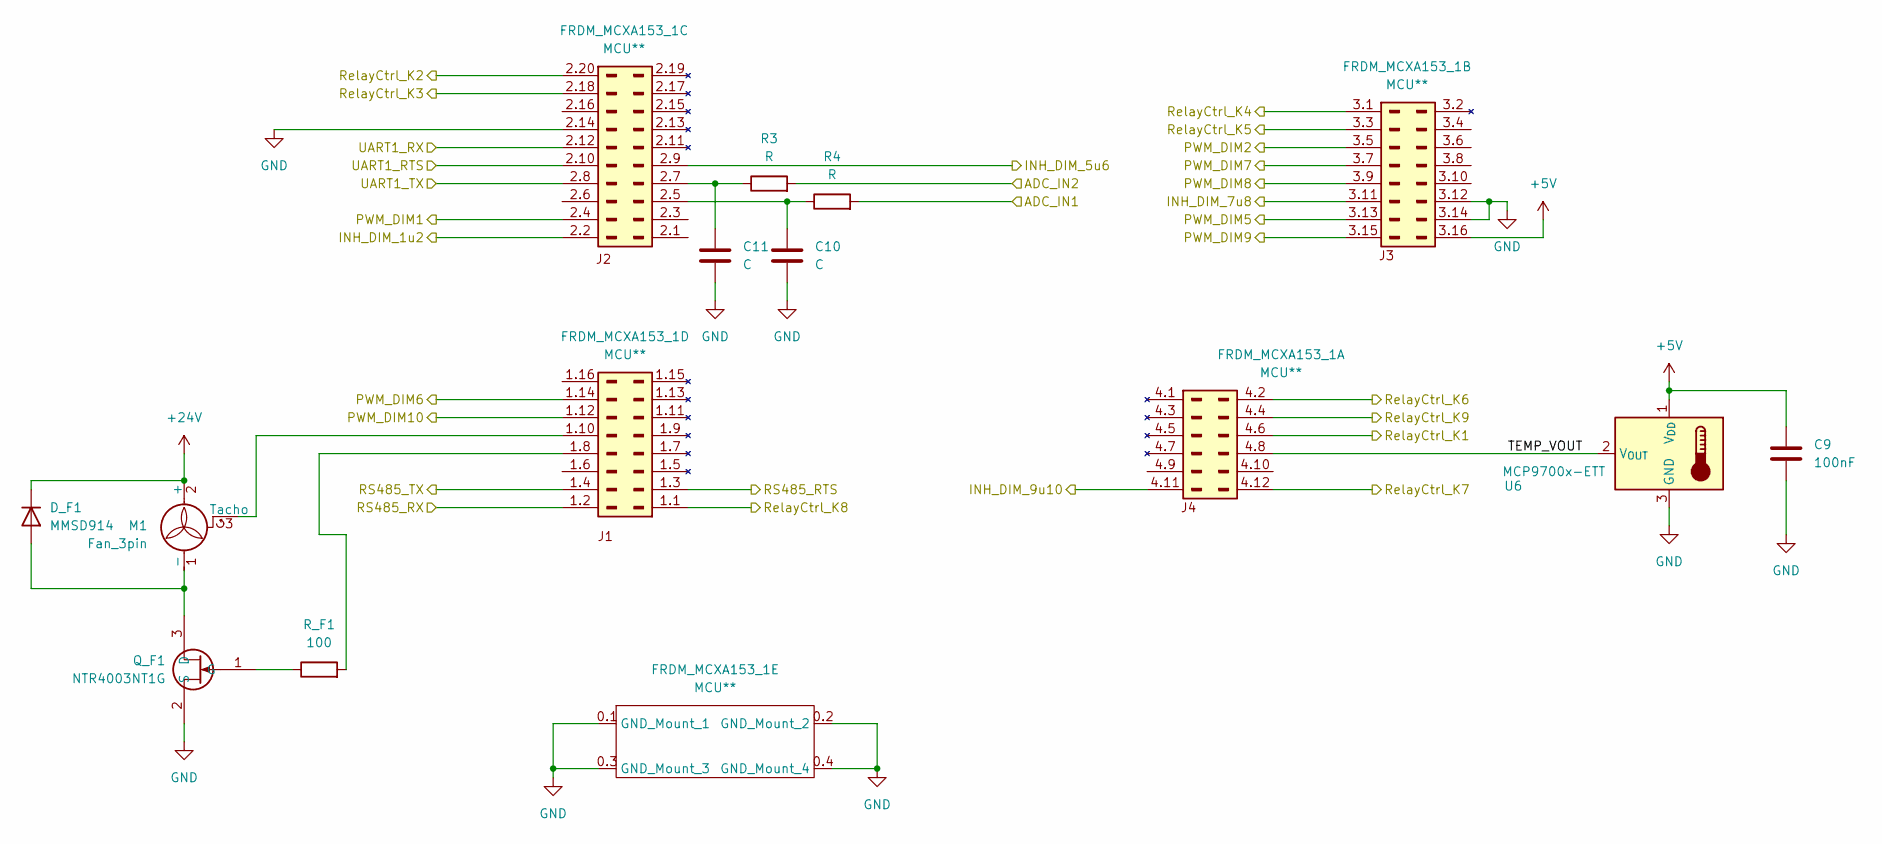
[picture p6: schematic FRDM-MCXN947.kicad_sch]

Parts:
C9: 100nF; C_0603_1608Metric
C10, C11: C; C_0603_1608Metric
D_F1: MMSD914; D_SOD-123
FRDM_MCXA153_1: MCU**; FRDM-MCXA153-SMD
M1: Fan_3pin; FanPinHeader_1x03_P2.54mm_Vertical
Q_F1: NTR4003NT1G; SOT-23-3; Mouser Part Number 863-NTR4003NT1G
R3, R4: R; R_0603_1608Metric
R_F1: 100; R_0603_1608Metric
U6: MCP9700x-ETT; SOT-23

Connections:
+5V: C9.1, FRDM_MCXA153_1.3.16 (Pin_J3_16_VIN), U6.1 (V_{DD}); also elsewhere on the board
+24V: D_F1.1 (K), M1.2 (+); also elsewhere on the board
/ADC_IN1: R4.2; also elsewhere on the board
/ADC_IN2: R3.2; also elsewhere on the board
/FRDM-MCXA153/RS485_RTS: FRDM_MCXA153_1.1.3 (Pin_J1_3); also elsewhere on the board
/FRDM-MCXA153/RS485_RX: FRDM_MCXA153_1.1.2 (Pin_J1_2); also elsewhere on the board
/FRDM-MCXA153/RS485_TX: FRDM_MCXA153_1.1.4 (Pin_J1_4); also elsewhere on the board
/FRDM-MCXA153/TEMP_VOUT: FRDM_MCXA153_1.4.8 (Pin_8), U6.2 (V_{OUT})
/INH_DIM_1u2: FRDM_MCXA153_1.2.2 (Pin_J2_2); also elsewhere on the board
/INH_DIM_5u6: FRDM_MCXA153_1.2.9 (Pin_J2_9); also elsewhere on the board
/INH_DIM_7u8: FRDM_MCXA153_1.3.11 (Pin_J3_11); also elsewhere on the board
/INH_DIM_9u10: FRDM_MCXA153_1.4.11 (Pin_11); also elsewhere on the board
/PWM_DIM1: FRDM_MCXA153_1.2.4 (Pin_J2_4); also elsewhere on the board
/PWM_DIM2: FRDM_MCXA153_1.3.5 (Pin_J3_5); also elsewhere on the board
/PWM_DIM5: FRDM_MCXA153_1.3.13 (Pin_J3_13); also elsewhere on the board
/PWM_DIM6: FRDM_MCXA153_1.1.14 (Pin_J1_14); also elsewhere on the board
/PWM_DIM7: FRDM_MCXA153_1.3.7 (Pin_J3_7); also elsewhere on the board
/PWM_DIM8: FRDM_MCXA153_1.3.9 (Pin_J3_9); also elsewhere on the board
/PWM_DIM9: FRDM_MCXA153_1.3.15 (Pin_J3_15); also elsewhere on the board
/PWM_DIM10: FRDM_MCXA153_1.1.12 (Pin_J1_12); also elsewhere on the board
/RelayCtrl_K1: FRDM_MCXA153_1.4.6 (Pin_6); also elsewhere on the board
/RelayCtrl_K2: FRDM_MCXA153_1.2.20 (Pin_J2_20); also elsewhere on the board
/RelayCtrl_K3: FRDM_MCXA153_1.2.18 (Pin_J2_18); also elsewhere on the board
/RelayCtrl_K4: FRDM_MCXA153_1.3.1 (Pin_J3_1); also elsewhere on the board
/RelayCtrl_K5: FRDM_MCXA153_1.3.3 (Pin_J3_3); also elsewhere on the board
/RelayCtrl_K6: FRDM_MCXA153_1.4.2 (Pin_2); also elsewhere on the board
/RelayCtrl_K7: FRDM_MCXA153_1.4.12 (Pin_12); also elsewhere on the board
/RelayCtrl_K8: FRDM_MCXA153_1.1.1 (Pin_J1_1); also elsewhere on the board
/RelayCtrl_K9: FRDM_MCXA153_1.4.4 (Pin_4); also elsewhere on the board
/UART1_RTS: FRDM_MCXA153_1.2.10 (Pin_J2_10); also elsewhere on the board
/UART1_RX: FRDM_MCXA153_1.2.12 (Pin_J2_12); also elsewhere on the board
/UART1_TX: FRDM_MCXA153_1.2.8 (Pin_J2_8); also elsewhere on the board
GND: C9.2, C10.2, C11.2, FRDM_MCXA153_1.0.1 (GND_Mount_1), FRDM_MCXA153_1.0.2 (GND_Mount_2), FRDM_MCXA153_1.0.3 (GND_Mount_3), FRDM_MCXA153_1.0.4 (GND_Mount_4), FRDM_MCXA153_1.2.14 (GND), FRDM_MCXA153_1.3.12 (Pin_J3_12_GND), FRDM_MCXA153_1.3.14 (Pin_J3_14_GND), Q_F1.2 (S), U6.3 (GND); also elsewhere on the board
unnamed: D_F1.2 (A), M1.1 (-), Q_F1.3 (D)
unnamed: C10.1, FRDM_MCXA153_1.2.5 (Pin_J2_5), R4.1
unnamed: C11.1, FRDM_MCXA153_1.2.7 (Pin_J2_7), R3.1
unnamed: FRDM_MCXA153_1.1.8 (Pin_J1_8), R_F1.2
unnamed: FRDM_MCXA153_1.1.10 (Pin_J1_10), M1.3 (Tacho)
unnamed: Q_F1.1 (G), R_F1.1
