LukiBa/RS485-IO-Extension/io-gateway/io-gateway.kicad_pcb

## KiCad design io-gateway/io-gateway.kicad_pcb (continued)

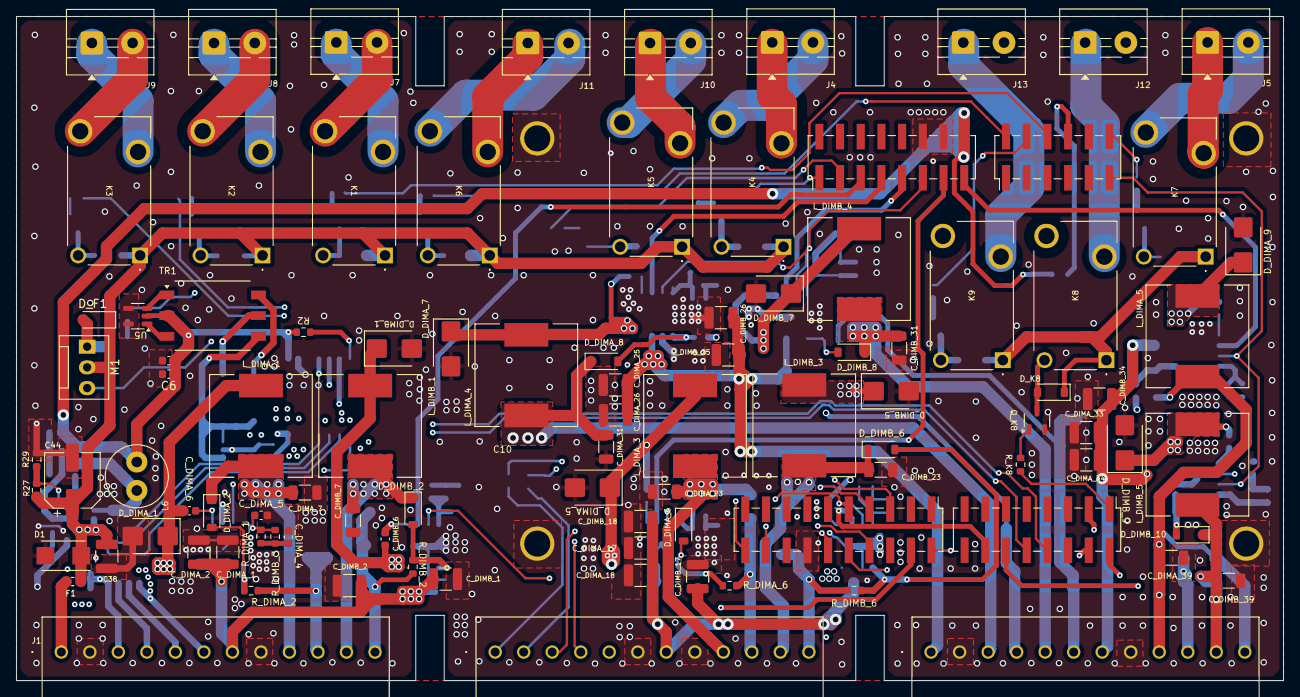
[picture p7: board io-gateway.kicad_pcb from above]

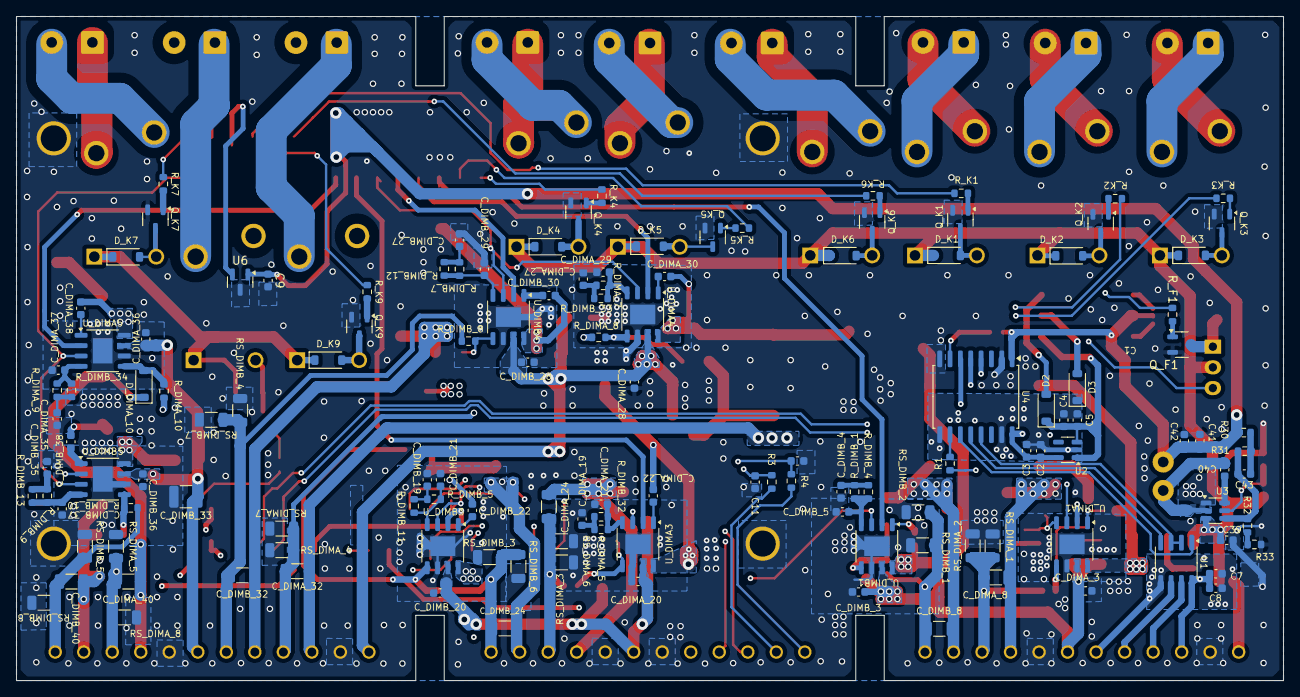
[picture p8: board io-gateway.kicad_pcb from below]

Board: 4 copper layers, 155.5 x 81.5 mm, 229 parts (134 on the bottom side), 156 nets.
