LukiBa/RS485-IO-Extension/(commit log)

2025-07-24 schematic init
    [io-gateway.kicad_pcb, io-gateway.kicad_sch]
2025-07-24 temp commit
    [io-gateway.kicad_sch]
2025-07-25 buck regulator schematic ready
    [io-gateway.kicad_pcb]
2025-07-25 buck regulator ready
    [io-gateway.kicad_sch]
2025-07-27 PCB Settings
2025-07-28 add some datasheets
    [IO_Overview.xlsx, io-gateway.kicad_pcb, io-gateway.kicad_sch]
2025-08-01 add Terminal Blocks
    [IO_Overview.xlsx, io-gateway.kicad_pcb, io-gateway.kicad_sch, untitled.kicad_sch]
2025-08-07 Label Terminal Block Pins
    [io-gateway.kicad_pcb, untitled.kicad_sch]
2025-08-07 add relays
    [FRDM-MCXN947.kicad_sch, io-gateway.kicad_pcb, io-gateway.kicad_sch, relays.kicad_sch, untitled.kicad_sch]
2025-08-11 update mcu lib
    [FRDM-MCXN947.kicad_sch, relays.kicad_sch]
2025-08-14 Place Relays
    [FRDM-MCXN947.kicad_sch, io-gateway.kicad_pcb, io-gateway.kicad_sch, relaysJ5.kicad_sch, relaysJ6.kicad_sch, untitled.kicad_sch]
2025-08-26 add dimmer
    [FRDM-MCXN947.kicad_sch, dimmer1.kicad_sch, io-gateway.kicad_sch]
2025-09-01 layout for first dimmer
    [FRDM-MCXN947.kicad_sch, dimmer1.kicad_sch, io-gateway.kicad_pcb, io-gateway.kicad_sch, relays.kicad_sch, relaysJ5.kicad_sch, untitled.kicad_sch]
2025-09-03 add second dimmer
    [dimmer1.kicad_sch, io-gateway.kicad_pcb]
2025-09-04 add voltage regulator
    [VoltageRegulator.kicad_sch, io-gateway.kicad_pcb, io-gateway.kicad_sch]
2025-09-05 reannotate dimmers and relays
    [dimmer1.kicad_sch, io-gateway.kicad_pcb, io-gateway.kicad_sch, relays.kicad_sch]
2025-09-05 duplicate dimmer
    [io-gateway.kicad_pcb, io-gateway.kicad_sch]
2025-09-08 Place some Relays
    [io-gateway.kicad_pcb, io-gateway.kicad_sch]
2025-09-08 fix some drc issues
    [FRDM-MCXN947.kicad_sch, dimmer1.kicad_sch, io-gateway.kicad_pcb, io-gateway.kicad_sch]
2025-09-08 Connect some Relays
    [io-gateway.kicad_pcb]
2025-09-09 all dimmers placed
    [io-gateway.kicad_pcb]
2025-09-10 Change Holes to Vias
    [FRDM-MCXN947.kicad_sch, io-gateway.kicad_pcb, relays.kicad_sch]
2025-09-12 connect Relays in Schematics
    [FRDM-MCXN947.kicad_sch, io-gateway.kicad_pcb, io-gateway.kicad_sch]
2025-09-15 add RS485
    [FRDM-MCXN947.kicad_sch, dimmer1.kicad_sch, io-gateway.kicad_pcb, io-gateway.kicad_sch, relaysJ6.kicad_sch]
2025-09-16 upd rs485
    [io-gateway.kicad_pcb, io-gateway.kicad_sch, relaysJ6.kicad_sch]
2025-09-16 connect rs485
    [io-gateway.kicad_pcb, relaysJ6.kicad_sch]
2025-09-22 connect all relays
    [FRDM-MCXN947.kicad_sch, io-gateway.kicad_pcb]
2025-09-22 connect inh pins
    [FRDM-MCXN947.kicad_sch, io-gateway.kicad_pcb, io-gateway.kicad_sch]
2025-09-23 improve ground connections
    [io-gateway.kicad_pcb]
2025-09-25 remove 2 Dimmer
    [IO_Overview.xlsx, dimmer1.kicad_sch, io-gateway.kicad_pcb, io-gateway.kicad_sch]
2025-10-09 gen gerbers
    [FRDM-MCXN947.kicad_sch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]
2025-10-13 fix minor issues
    [FRDM-MCXN947.kicad_sch, IO_Overview.xlsx, bom1.csv, dimmer1.kicad_sch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]
2025-10-15 order V1.0
    [bom1.xlsx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]
